eli-lame/Genli/stage2-carrier/stage2-carrier.kicad_pcb

## KiCad design pcie_upstream.kicad_sch

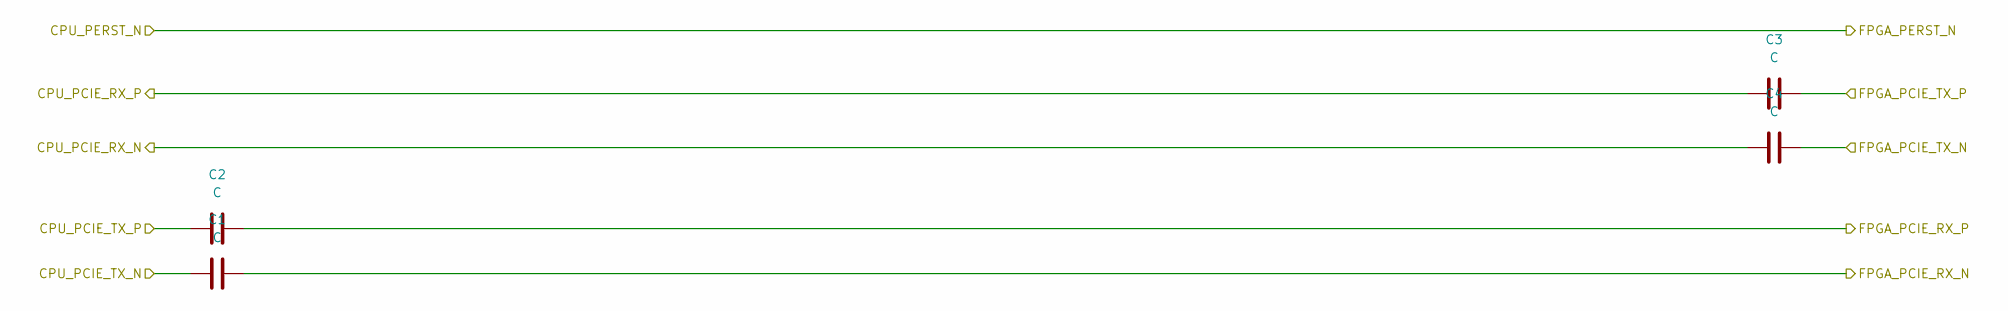
[picture p1: schematic pcie_upstream.kicad_sch]

Parts:
C1, C2, C3, C4: C; PQFP-160_28x28mm_P0.65mm

Connections:
CPU_PCIE_RX_N: C4.1
CPU_PCIE_RX_P: C3.1
CPU_PCIE_TX_N: C1.1
CPU_PCIE_TX_P: C2.1
FPGA_PCIE_RX_N: C1.2
FPGA_PCIE_RX_P: C2.2
FPGA_PCIE_TX_N: C4.2
FPGA_PCIE_TX_P: C3.2
