eli-lame/Genli/(commit log)

2026-08-18 Initial HOPCopter PDB schematic
    [Genli.kicad_pcb, Genli.kicad_sch]
2026-08-19 revamp esp symbols and finalize schematic (erc passed)
    [Genli.kicad_sch]
2026-08-19 assign all footprints
    [Genli.kicad_sch]
2026-08-20 update schematic with on-off switch adapter and update pcb design with matching footprints
    [Genli.kicad_pcb, Genli.kicad_sch]
2026-08-21 touch up pcb layout
    [Genli.kicad_pcb]
2026-08-22 update pcb trace
    [Genli.kicad_pcb]
2026-08-27 update pcb layout with cleaner traces; switch esc +/- connectors to soldered pad instead of screw terminal
    [Genli.kicad_pcb, Genli.kicad_sch]
2026-09-13 Stop tracking editor local-history and per-user KiCad state
    .history was tracked as a gitlink -- a stray submodule reference created by the
    VS Code local-history extension, which was never intended as project content.
    Genli.kicad_prl is per-user editor state.
2026-09-13 Save in-progress PCB layout changes
    Working-tree changes that predate the repository restructure; committed as
    their own change so the restructure starts from a clean tree.
    [Genli.kicad_pcb]
2026-09-13 Restructure as a multi-board repository and vendor every library
    This repository now holds all board work for the Revali hopcopter, with
    firmware and design documentation in eli-lame/Revali. One KiCad project per
    board, side by side: v1-prototype/ (archived, never fabricated) and
    stage2-carrier/ (current work).
    Vendor every non-stock symbol and footprint under lib/, registered per project
    with ${KIPRJMOD}-relative paths. This fixes a real defect: the symbol library
    was referenced by an absolute path into OneDrive/Documents, outside the project
    folder and committed nowhere, so a clone of this repository could not resolve
    its own symbols. The ESP32 devkit symbol and footprint came from a sepa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
    [Genli.kicad_pcb, Genli.kicad_sch]
2026-09-14 Scaffold the Stage 2 carrier board project
    Creates stage2-carrier as an empty KiCad project beside its specification, so
    the four vendored libraries resolve through the ${KIPRJMOD}/../lib paths
    already committed in that directory.
    Two corrections from creating it. KiCad's "create a new folder for the project"
    default had nested the project one level deeper than its library tables, where
    ${KIPRJMOD}/../lib would have resolved to a directory that does not exist and
    nothing would have loaded. And a stray Genli.kicad_pro, byte-identical to the
    archived one, had reappeared at the repository root -- recreated by KiCad from
    its recent-projects list pointing at the pre-restructure path.
    Co-Authore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
    [stage2-carrier.kicad_pcb, stage2-carrier.kicad_sch]
2026-09-14 Populate default project settings for the Stage 2 carrier
    KiCad wrote its default settings into the project file the first time it was
    opened; the committed scaffold was an empty stub. No schematic or board content
    yet.
2026-09-16 Correct the regulator to five pins and move the power switch to SHDN
    The Pololu D24V10F5 has five connections -- VIN, GND, VOUT, SHDN and PG -- not
    the three this spec assumed. That changes its symbol and footprint, and it
    changes the power switch.
    SHDN pulled low shuts the regulator down, so J8 moves from the BAT path onto
    SHDN. Switching SHDN is signal level: no current, no raw pack voltage on a
    mechanical contact a crash can knock, and nothing in series with the supply to
    add resistance or fail open. The trade is that BAT stays present when switched
    off and the divider keeps drawing ~138 uA, which is irrelevant beside pack
    self-discharge. Leaving J8 unfitted is now the do-nothing default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
    [Genli.kicad_sch, stage2-carrier.kicad_sch]
2026-09-17 Drop current sensing from the Stage 2 board entirely
    Previously the current-sense trace was routed with its series resistor left
    unpopulated, on the reasoning that pads are cheaper than a respin. That
    reasoning does not hold here. Skystars does not publish the KO50A's full-scale
    output voltage and anything above 3.3 V destroys the ADC pin, so a routed trace
    is a hazard until someone measures it -- work this board does not need. And
    Stage 3 is already a planned new board, so the respin the reservation was
    insuring against exists regardless.
    J1 pin 8 now takes a no-connect flag, GPIO 35 stays free, and the filter and
    resistor footprints are gone. Voltage sensing, which the low-battery failsaf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
2026-09-18 Specify the ToF connectors as 1x6 headers with strain relief
    The ToF sensors mount out at the frame and connect by wire, so J4 and J5 are
    through-hole headers rather than the JST-SH parts previously specified.
    Six positions, not five: the VL53L0X symbol has six pins and every symbol pin
    needs a matching pad number, so a 5-pad footprint fails with unmapped pins even
    though GPIO1 is unused. Position 5 sits unconnected. The symbol stays a
    VL53L0X rather than a generic connector because its pin names document what
    each wire carries; only the footprint field makes it a connector.
    Records why these are connectors at all -- the estimator turns the difference
    between the two ranges into a ground s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
2026-09-18 Settle the I2C pull-ups and record the 3.3 V requirement for the ToF connectors
    The VL53L0X carrier schematic shows 10 kilohm pull-ups on SDA and SCL, so two
    breakouts on one bus give about 5 kilohm in parallel and R5/R6 stay
    unpopulated. The footprints remain, for a different reason than before: the
    sensors hang off 10-15 cm of cable, and at 400 kHz I2C allows only 300 ns of
    rise time. 5 kilohm against that capacitance is close to the limit, and fitting
    these two in parallel is the fix if the bus proves unreliable.
    More importantly, those pull-ups connect to VIN rather than to a regulated
    rail, so SDA and SCL sit at whatever VIN is. The breakout accepts 5 V -- it has
    its own regulator and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
2026-09-19 Use a bidirectional TVS so it cannot be fitted backwards
    SMBJ20CA rather than SMBJ20A. Same package, same price, same clamping for the
    positive transients this board sees, and no polarity to get wrong.
    A reversed unidirectional TVS is forward-biased across the supply at about
    0.7 V -- a permanent short on the battery that presents as a dead board, with
    nothing visible to distinguish it from a correctly fitted part once soldered.
    Removing that failure mode is worth more than what the unidirectional part
    offers, which is an accidental reverse-polarity crowbar in combination with F1.
    With the ESC connector keyed, reverse polarity is already close to impossible.
    No schematic change: KiCad's De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
2026-09-20 Swap the ELRS UART direction and drop the buzzer
    ELRS TX is now GPIO 16 and RX is GPIO 17, reversing the previous assignment.
    The pins are interchangeable -- the ESP32 routes UART through its GPIO matrix
    -- so this is a layout convenience, but the crossover has to stay correct and
    will not be tested until a receiver is first plugged in.
    J6 is a 1x4 2.54 mm header rather than JST-SH, leaving J1 as the only
    fine-pitch connector on the board.
    The buzzer is removed to free routing space. Its value was audible arming
    feedback, and the status LED now carries that job alone -- firmware should make
    its arm and disarm states unambiguous rather than subtle. GPIO 13 stays
    reserved, and a passive piez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
2026-09-20 Keep the buzzer, and describe the circuit that is actually built
    Reverts the removal. Also corrects the description, which had been stale since
    the part was chosen: it documented an active buzzer switched by a 2N7002 with a
    gate resistor, pulldown and flyback diode, but the board carries a passive
    piezo driven straight from GPIO 13 through a single 100 ohm resistor.
    A passive piezo is essentially a capacitor and draws almost no current, so no
    transistor is needed, and it is non-polarised so orientation is irrelevant. It
    does need PWM near 4 kHz -- it makes no sound from a DC level -- which is the
    one thing firmware has to know. J7 is a 1x2 header with the element mounted
    off-board, since bu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
2026-09-20 Move IMU INT to GPIO 35 in the pin budget and J3 table
    Matches the change in Revali's hardware.md. Records why GPIO 35's lack of an
    internal pull matters: the ICM-20948's INT must stay push-pull, and the
    interrupt handler has to be attached after IMU init because the pin floats
    until the sensor drives it.
2026-09-21 Swap IMU SCLK to GPIO 25 and ToF A XSHUT to GPIO 18
    Matches Revali's hardware.md. Puts the two XSHUT lines on opposite devkit pin
    rows, matching J4 and J5 being on opposite board edges.
    Records that GPIO 25 is not a VSPI default, so firmware must name the SPI pins
    explicitly or a bare SPI.begin() will drive GPIO 18 -- now a ToF reset line --
    as the clock.
2026-09-21 Swap IMU SCLK to GPIO 19 and MISO to GPIO 25
    Matches Revali's hardware.md. Both SPI signals are now off their VSPI defaults,
    so the note records the explicit SPI.begin argument order and why transposing
    the first two is a silent failure.
2026-09-21 Sync the spec's pin assignments to the routed board
    IMU CS 5 to 15, SCLK 19 to 23, MOSI 23 to 19, and I2C SDA and SCL swapped to 22
    and 21. GPIO 4 and 5 are both free; 36 and 39 remain as the input-only ADC1
    spares. Matches Revali's hardware.md.
    Every SPI pin and both I2C pins are now off their framework defaults, so the
    explicit begin() calls and their argument orders are recorded -- a bare
    SPI.begin() would drive GPIO 18, which resets a ToF, and a bare Wire.begin()
    has SDA and SCL crossed. Neither errors; the sensors just never answer.
    Also fixes the pin budget's stale claim that GPIO 15, 36 and 39 go to a spare
    header J9, which was deleted during layout.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
2026-09-21 Reconcile the spec against the board as built
    Designators, dimensions and the bill of materials were still describing an
    early draft. All three now come from the board file rather than from an
    accumulated chain of intentions.
    Outline is 58 x 88 mm, confirmed from Edge.Cuts. That overhangs the KO50A on
    every side and leaves roughly 29 mm of unsupported board past the mounting
    square at the long ends, so the note now says to keep the heavy parts -- C10
    and U2 -- near that square and to stake the electrolytic.
    Designators renamed throughout to match: the ESC ribbon is J3, ELRS is J2, the
    IMU is U3, the regulator is U2, the TVS is D2 and the LED is D1, the divider
    legs are R2 (100k) and R1 (22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
